mwelling/kimchi-display-lid/3D/QFN_6DSLTR_STM.step

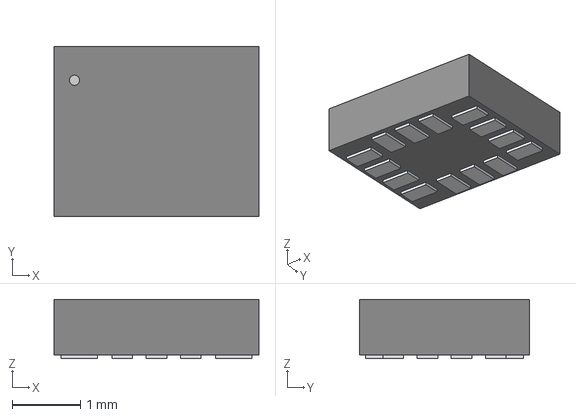
[picture p1: CAD file, 2021-01-25]
3D/QFN_6DSLTR_STM.step
3.00 x 2.49 x 0.866 mm
