mwelling/kimchi-display-lid/subassy/hoverboard/hoverboard.step

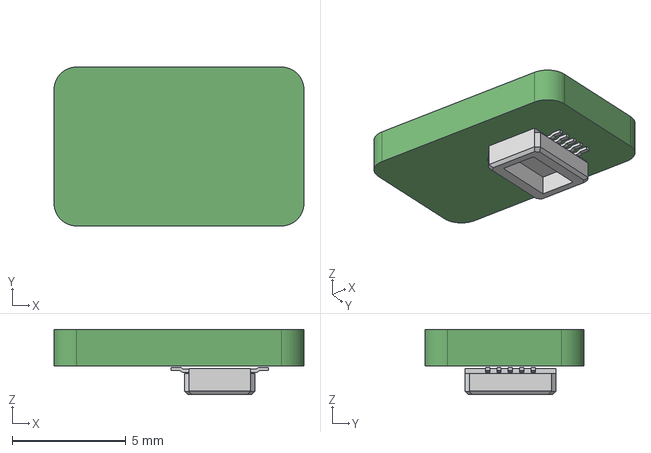
[picture p2: CAD file, 2021-01-31]
subassy/hoverboard/hoverboard.step
11.0 x 7.00 x 2.87 mm
