mwelling/kimchi-display-lid/3D/LCFE1210_LTF.step

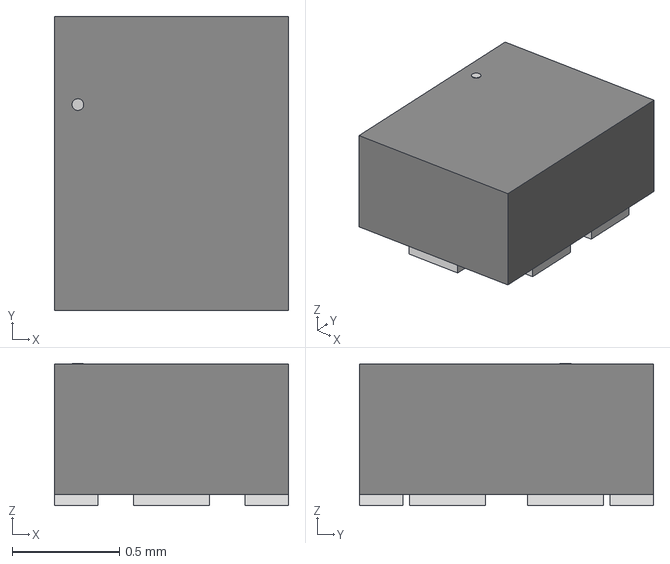
[picture p3: CAD file, 2020-12-23]
3D/LCFE1210_LTF.step
1.09 x 1.37 x 0.663 mm
