mwelling/kimchi-display-lid/3D/LGA-24L_3.5x3_0.43p.step

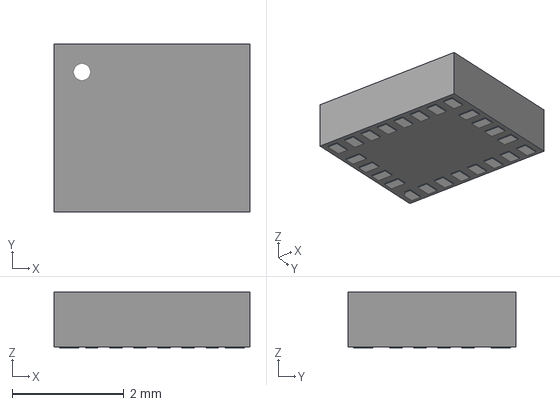
[picture p4: CAD file, 2020-12-20]
3D/LGA-24L_3.5x3_0.43p.step
3.50 x 3.00 x 1.00 mm
