mwelling/kimchi-display-lid/3D/1-292303-6.stp

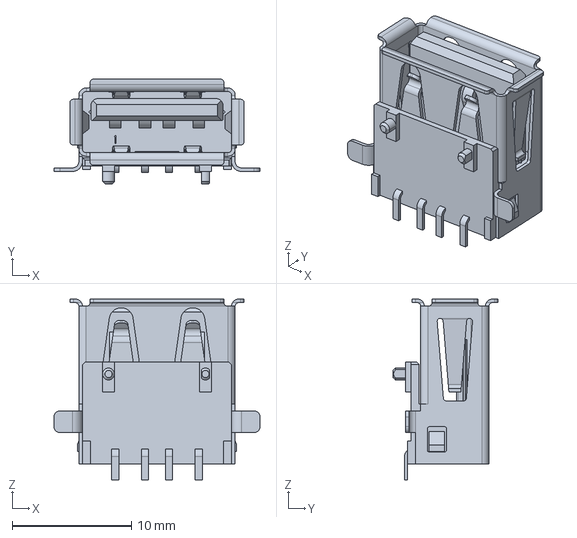
[picture p5: CAD file, 2020-12-20]
3D/1-292303-6.stp
17.3 x 8.79 x 15.2 mm
