mwelling/kimchi-display-lid/kimchi_display_lid.kicad_pcb

## KiCad design kimchi_display_lid.kicad_pcb (2021-02-05)

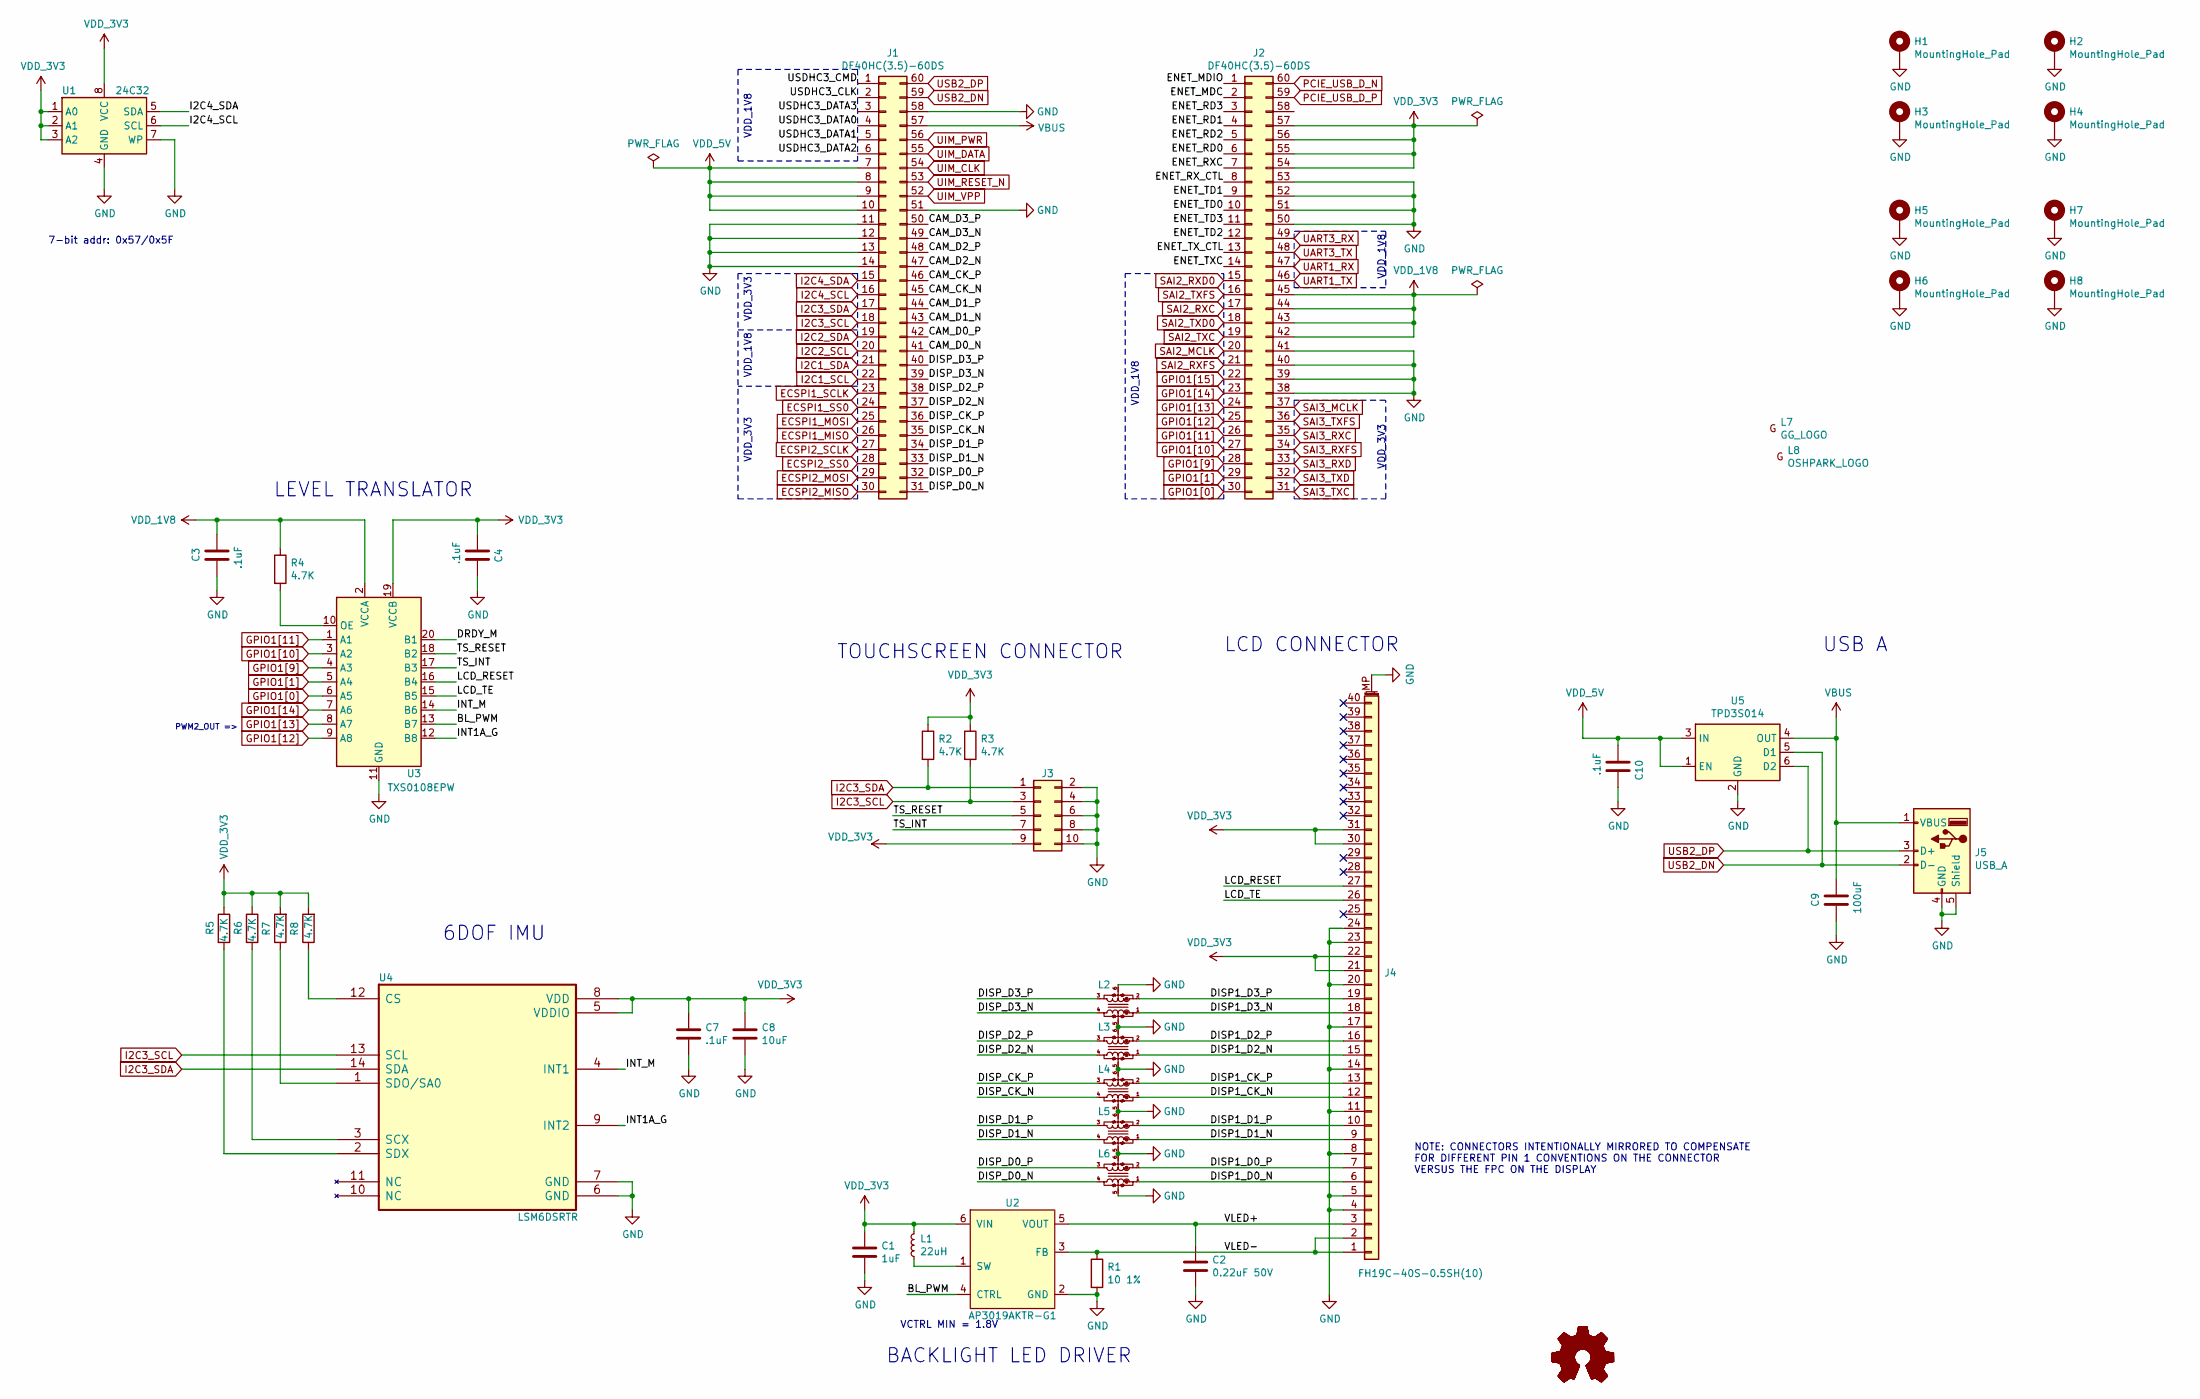
[picture p6: schematic kimchi_display_lid.sch]

Parts:
C1: 1uF; C_0603_1608Metric; Part C0603C105K4PAC7411
C2: 0.22uF 50V; C_0603_1608Metric; Part CGA3E3X7R1H224K080AB
C3, C4, C7, C10: .1uF; C_0603_1608Metric; Part C0603C104M5RACAUTO
C8: 10uF; C_0603_1608Metric; Part CL10A106MP8NNNC
C9: 100uF; C_1206_3216Metric; Part CC1206MKX5R5BB107
H1, H2, H3, H4, H5, H6, H7, H8: MountingHole_Pad; MountingHole_3mm_Pad
J1, J2: DF40HC(3.5)-60DS; Part DF40HC(3.5)-60DS
J3: Conn_02x05_Odd_Even; HIROSE_DF23C-10DS-0.5V(51)
J4: FH19C-40S-0.5SH(10); HRS_FH19C-40S-0.5SH_1x40-1MP_P0.50mm; Part FH19C-40S-0.5SH(10)
J5: USB_A; TE_1-292303-6; Part 1-292303-6
L1: 22uH; L_Taiyo-Yuden_MD-4040; Part TYA4012220M-10
L2, L3, L4, L5, L6: LCFE121002; Part LCFE121002
L7: GG_LOGO; groupgets_logo
L8: OSHPARK_LOGO; oshpark_logo
LOGO1: Logo_Open_Hardware_Small; OSHW-Logo_5.7x6mm_SilkScreen
LOGO2: Logo_Open_Hardware_Small; kimchi-micro-3d-model
LOGO3: Logo_Open_Hardware_Small; hoverboard-3d-model
R1: 10 1%; R_0603_1608Metric; Part RE0603FRE0710RL
R2, R3, R4, R5, R6, R7, R8: 4.7K; R_0603_1608Metric; Part RC0603JR-074K7L
U1: 24C32; DFN-8-1EP_3x2mm_P0.5mm_EP1.36x1.46mm; Part M24C32-FMC6TG
U2: AP3019AKTR-G1; SOT-23-6; Part AP3019AKTR-G1
U3: TXS0108EPW; TSSOP-20_4.4x6.5mm_P0.65mm; Part TXS0108EPW
U4: LSM6DSRTR
U5: TPD3S014; SOT-23-6; Part TPD3S014

Connections:
/BL_PWM: U2.4 (CTRL), U3.13 (B7)
/CAM_CK_N: J1.45
/CAM_CK_P: J1.46
/CAM_D0_N: J1.41
/CAM_D0_P: J1.42
/CAM_D1_N: J1.43
/CAM_D1_P: J1.44
/CAM_D2_N: J1.47
/CAM_D2_P: J1.48
/CAM_D3_N: J1.49
/CAM_D3_P: J1.50
/DISP1_CK_N: J4.12, L4.1
/DISP1_CK_P: J4.13, L4.2
/DISP1_D0_N: J4.6, L6.1
/DISP1_D0_P: J4.7, L6.2
/DISP1_D1_N: J4.9, L5.1
/DISP1_D1_P: J4.10, L5.2
/DISP1_D2_N: J4.15, L3.1
/DISP1_D2_P: J4.16, L3.2
/DISP1_D3_N: J4.18, L2.1
/DISP1_D3_P: J4.19, L2.2
/DISP_CK_N: J1.35, L4.4
/DISP_CK_P: J1.36, L4.3
/DISP_D0_N: J1.31, L6.4
/DISP_D0_P: J1.32, L6.3
/DISP_D1_N: J1.33, L5.4
/DISP_D1_P: J1.34, L5.3
/DISP_D2_N: J1.37, L3.4
/DISP_D2_P: J1.38, L3.3
/DISP_D3_N: J1.39, L2.4
/DISP_D3_P: J1.40, L2.3
/DRDY_M: U3.20 (B1)
/ENET_MDC: J2.2
/ENET_MDIO: J2.1
/ENET_RD0: J2.6
/ENET_RD1: J2.4
/ENET_RD2: J2.5
/ENET_RD3: J2.3
/ENET_RXC: J2.7
/ENET_RX_CTL: J2.8
/ENET_TD0: J2.10
/ENET_TD1: J2.9
/ENET_TD2: J2.12
/ENET_TD3: J2.11
/ENET_TXC: J2.14
/ENET_TX_CTL: J2.13
/INT1A_G: U3.12 (B8), U4.9 (INT2)
/INT_M: U3.14 (B6), U4.4 (INT1)
/LCD_RESET: J4.27, U3.16 (B4)
/LCD_TE: J4.26, U3.15 (B5)
/TS_INT: J3.7, U3.17 (B3)
/TS_RESET: J3.5, U3.18 (B2)
/USDHC3_CLK: J1.2
/USDHC3_CMD: J1.1
/USDHC3_DATA0: J1.4
/USDHC3_DATA1: J1.5
/USDHC3_DATA2: J1.6
/USDHC3_DATA3: J1.3
/VLED+: C2.1, J4.3, U2.5 (VOUT)
/VLED-: J4.1, J4.2, R1.1, U2.3 (FB)
ECSPI1_MISO: J1.26
ECSPI1_MOSI: J1.25
ECSPI1_SCLK: J1.23
ECSPI1_SS0: J1.24
ECSPI2_MISO: J1.30
ECSPI2_MOSI: J1.29
ECSPI2_SCLK: J1.27
ECSPI2_SS0: J1.28
GND: C1.2, C2.2, C3.2, C4.1, C7.2, C8.2, C9.2, C10.1, H1.1, H2.1, H3.1, H4.1, H5.1, H6.1, H7.1, H8.1, J1.11, J1.12, J1.13, J1.14, J1.51, J1.58, J2.38, J2.39, J2.40, J2.41, J2.50, J2.51, J2.52, J2.53, J3.2, J3.4, J3.6, J3.8, J3.10, J4.4, J4.5, J4.8, J4.11, J4.14, J4.17, J4.20, J4.23, J4.24, J4.MP (MountPin), J5.4 (GND), J5.5 (Shield), L2.5, L2.6 (5), L3.5, L3.6 (5), L4.5, L4.6 (5), L5.5, L5.6 (5), L6.5, L6.6 (5), R1.2, U1.4 (GND), U1.7 (WP), U2.2 (GND), U3.11 (GND), U4.6 (GND), U4.7 (GND), U5.2 (GND)
GPIO1[0]: J2.30, U3.6 (A5)
GPIO1[1]: J2.29, U3.5 (A4)
GPIO1[9]: J2.28, U3.4 (A3)
GPIO1[10]: J2.27, U3.3 (A2)
GPIO1[11]: J2.26, U3.1 (A1)
GPIO1[12]: J2.25, U3.9 (A8)
GPIO1[13]: J2.24, U3.8 (A7)
GPIO1[14]: J2.23, U3.7 (A6)
GPIO1[15]: J2.22
I2C1_SCL: J1.22
I2C1_SDA: J1.21
I2C2_SCL: J1.20
I2C2_SDA: J1.19
I2C3_SCL: J1.18, J3.3, R3.2, U4.13 (SCL)
I2C3_SDA: J1.17, J3.1, R2.2, U4.14 (SDA)
I2C4_SCL: J1.16, U1.6 (SCL)
I2C4_SDA: J1.15, U1.5 (SDA)
unnamed: L1.1, U2.1 (SW)
unnamed: R4.2, U3.10 (OE)
unnamed: R5.2, U4.2 (SDX)
unnamed: R6.2, U4.3 (SCX)
unnamed: R7.1, U4.1 (SDO/SA0)
unnamed: R8.1, U4.12 (CS)
PCIE_USB_D_N: J2.60
PCIE_USB_D_P: J2.59
SAI2_MCLK: J2.20
SAI2_RXC: J2.17
SAI2_RXD0: J2.15
SAI2_RXFS: J2.21
SAI2_TXC: J2.19
SAI2_TXD0: J2.18
SAI2_TXFS: J2.16
SAI3_MCLK: J2.37
SAI3_RXC: J2.35
SAI3_RXD: J2.33
SAI3_RXFS: J2.34
SAI3_TXC: J2.31
SAI3_TXD: J2.32
SAI3_TXFS: J2.36
UART1_RX: J2.47
UART1_TX: J2.46
UART3_RX: J2.49
UART3_TX: J2.48
UIM_CLK: J1.54
UIM_DATA: J1.55
UIM_PWR: J1.56
UIM_RESET_N: J1.53
UIM_VPP: J1.52
USB2_DN: J1.59, J5.2 (D-), U5.5 (D1)
USB2_DP: J1.60, J5.3 (D+), U5.6 (D2)
VBUS: C9.1, J1.57, J5.1 (VBUS), U5.4 (OUT)
VDD_1V8: C3.1, J2.42, J2.43, J2.44, J2.45, R4.1, U3.2 (VCCA)
VDD_3V3: C1.1, C4.2, C7.1, C8.1, J2.54, J2.55, J2.56, J2.57, J3.9, J4.21, J4.22, J4.30, J4.31, L1.2, R2.1, R3.1, R5.1, R6.1, R7.2, R8.2, U1.1 (A0), U1.2 (A1), U1.3 (A2), U1.8 (VCC), U2.6 (VIN), U3.19 (VCCB), U4.5 (VDDIO), U4.8 (VDD)
VDD_5V: C10.2, J1.7, J1.8, J1.9, J1.10, U5.1 (EN), U5.3 (IN)

Notes on the sheet:
7-bit addr: 0x57/0x5F
VDD_1V8
VDD_3V3
BACKLIGHT LED DRIVER
VCTRL MIN = 1.8V
TOUCHSCREEN CONNECTOR
LCD CONNECTOR
NOTE: CONNECTORS INTENTIONALLY MIRRORED TO COMPENSATE FOR DIFFERENT PIN 1 CONVENTIONS ON THE CONNECTOR VERSUS THE FPC ON THE DISPLAY
LEVEL TRANSLATOR
PWM2_OUT =>
USB A
6DOF IMU

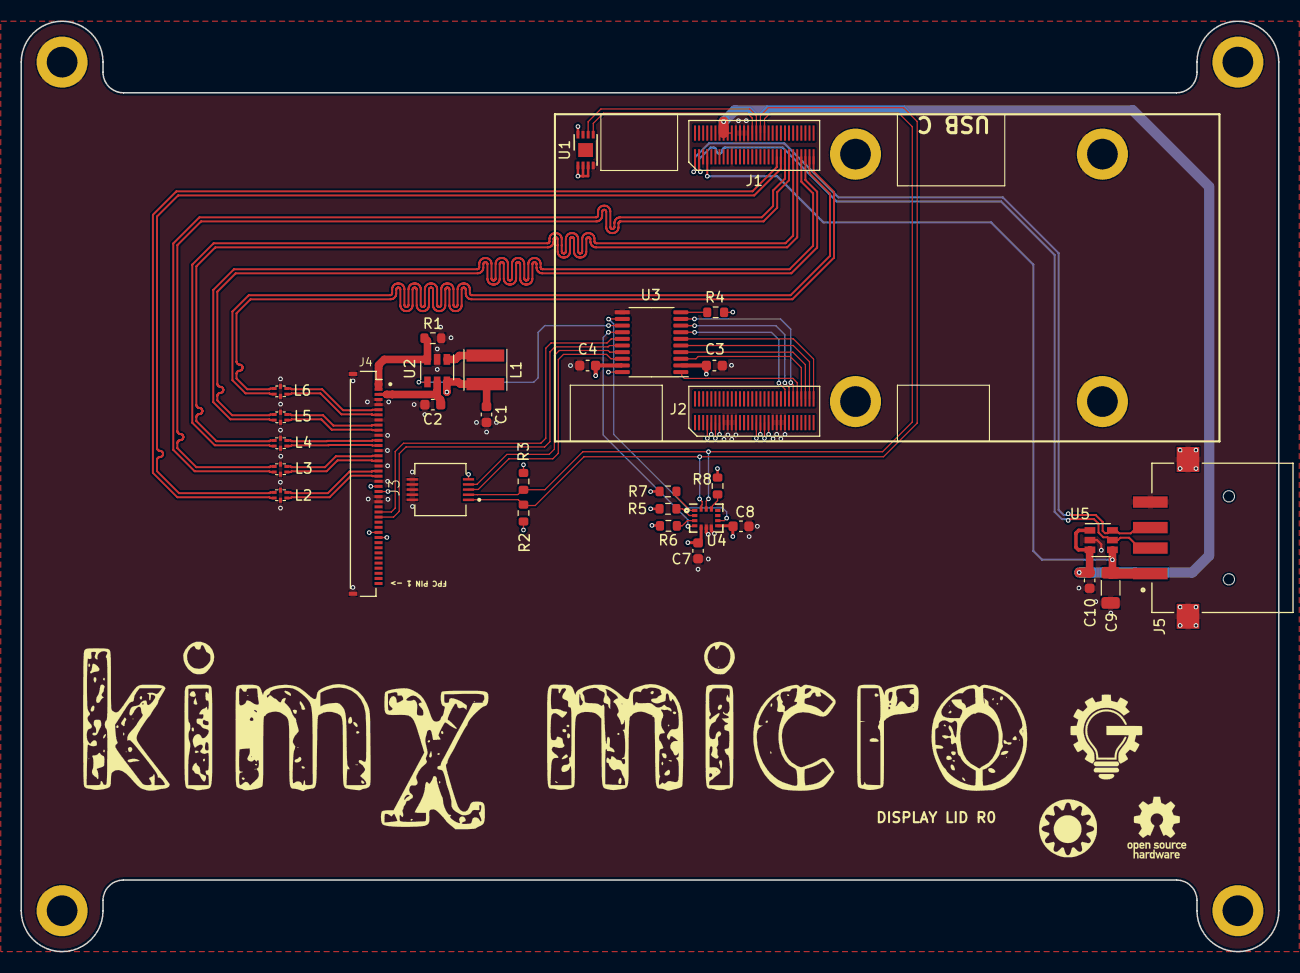
[picture p7: board kimchi_display_lid.kicad_pcb from above]

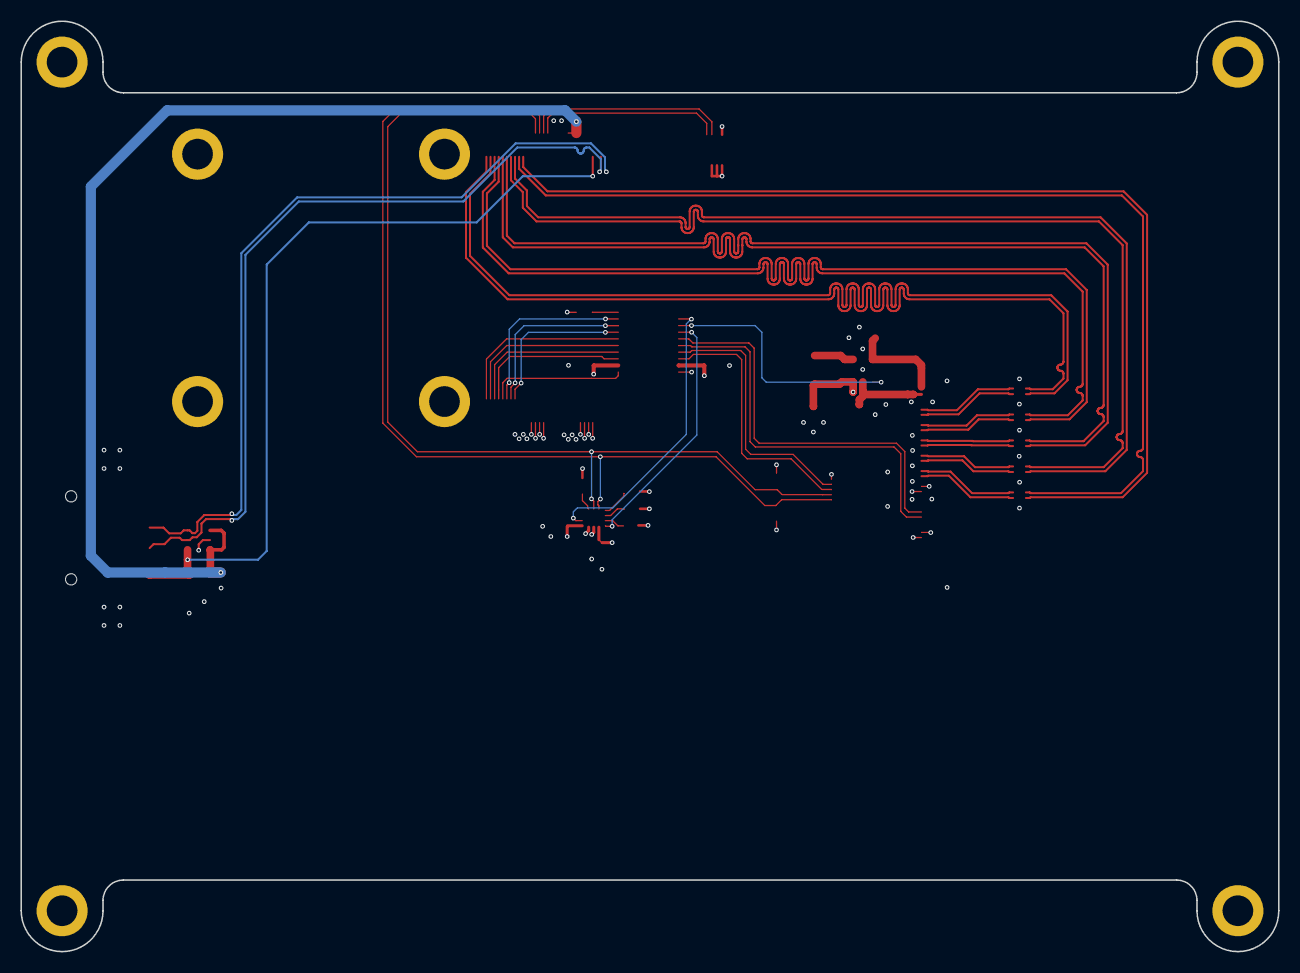
[picture p8: board kimchi_display_lid.kicad_pcb from below]

Board: 4 copper layers, 123.0 x 91.0 mm, 45 parts (8 on the bottom side), 54 nets.
