mwelling/kimchi-display-lid/kimchi_ulid.kicad_pcb

## KiCad design kimchi_ulid.kicad_pcb (2020-12-14)

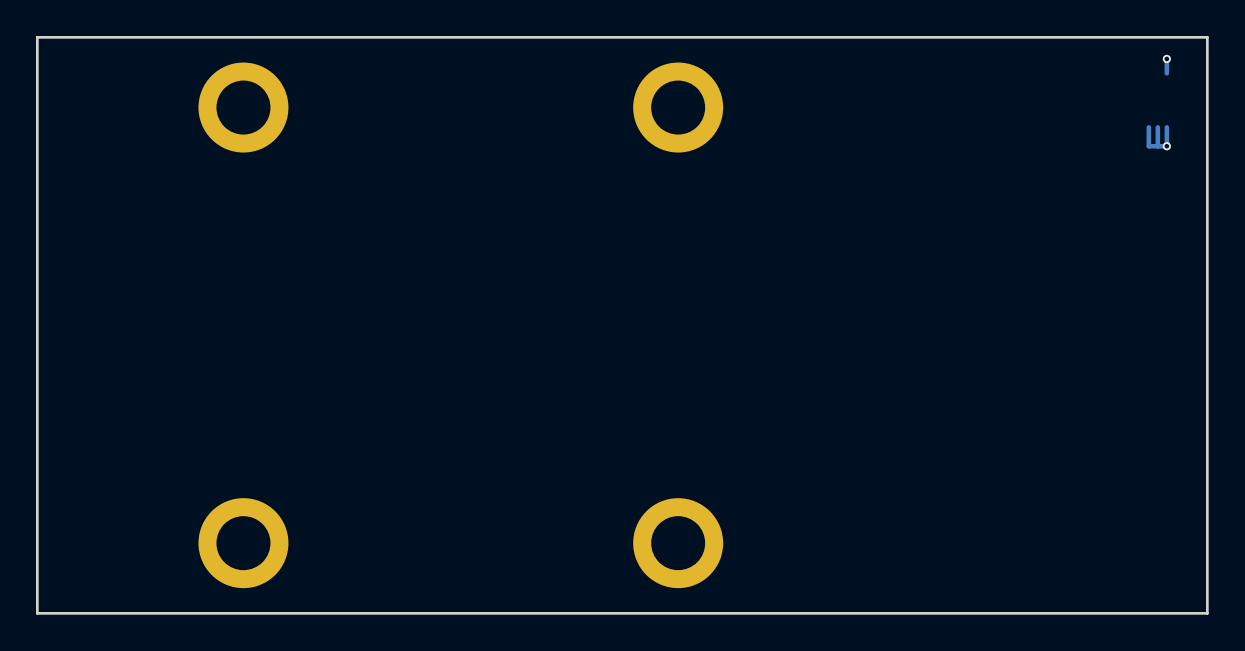
[picture p9: board kimchi_ulid.kicad_pcb from above]

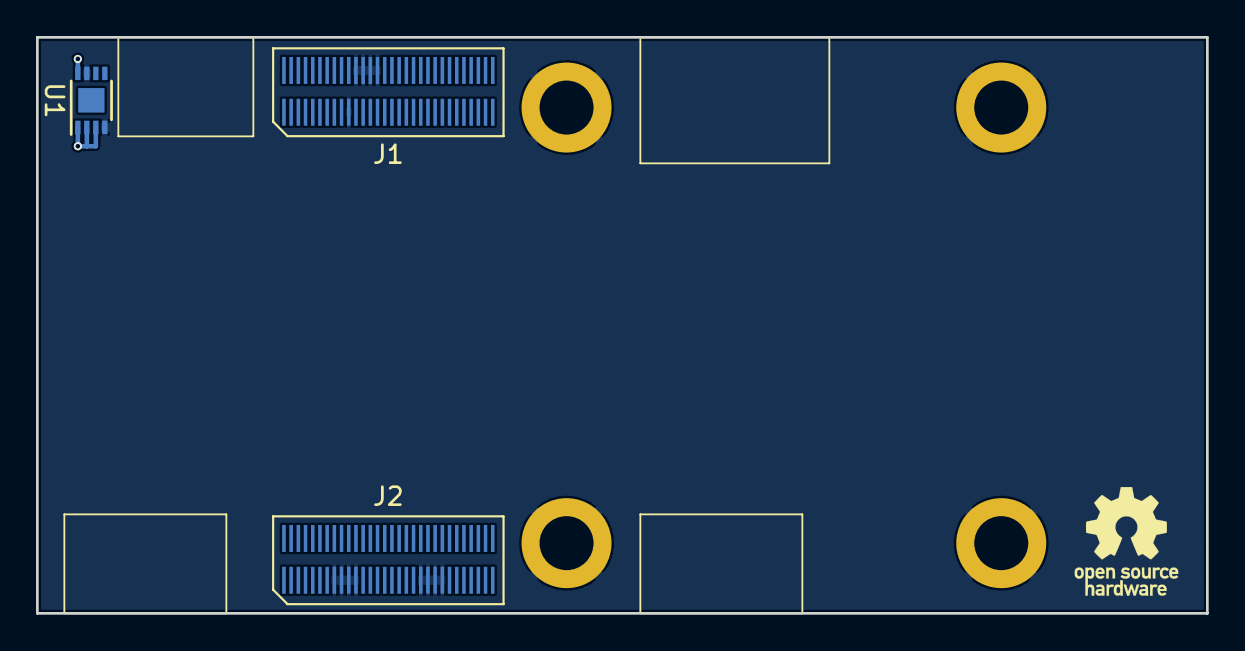
[picture p10: board kimchi_ulid.kicad_pcb from below]

Board: 4 copper layers, 65.0 x 32.0 mm, 8 parts (4 on the bottom side), 6 nets.

Parts:
H1, H2, H3, H4: MountingHole_Pad; MountingHole_3mm_Pad
J1, J2: DF40HC(3.5)-60DS
LOGO1: Logo_Open_Hardware_Small; OSHW-Logo_5.7x6mm_SilkScreen
U1: 24C32; DFN-8-1EP_3x2mm_P0.5mm_EP1.36x1.46mm

Connections:
GND: H1.1, H2.1, H3.1, H4.1, J1.11, J1.12, J1.13, J1.14, J1.51, J2.38, J2.39, J2.40, J2.41, J2.50, J2.51, J2.52, J2.53, U1.4, U1.7
I2C4_SCL: J1.16, U1.6
I2C4_SDA: J1.15, U1.5
VDD_1V8: J2.42, J2.43, J2.44, J2.45
VDD_3V3: J2.54, J2.55, J2.56, J2.57, U1.1, U1.2, U1.3, U1.8
VDD_5V: J1.7, J1.8, J1.9, J1.10
