mwelling/kimchi-display-lid/(commit log)

2020-12-14 Clean up
    [kimchi_display_lid.kicad_pcb, kimchi_display_lid.sch]
2020-12-14 Add board outline
    [kimchi_display_lid.kicad_pcb, kimchi_display_lid.sch]
2020-12-14 Add 3D model for the kimchi micro
    The PEMs are supposed to be 3.5mm but the spacing is enforced in the footprint.
    [kimchi_display_lid.kicad_pcb]
2020-12-14 Put 3D model in PCB
    For virtual fitment checks :)
    [kimchi_display_lid.kicad_pcb]
2020-12-14 Add LCD backlight LED driver
    [kimchi_display_lid.kicad_pcb, kimchi_display_lid.sch]
2020-12-14 Bump inductor to a big package
    [kimchi_display_lid.kicad_pcb, kimchi_display_lid.sch]
2020-12-14 Add some manufacturer part numbers
    So I don't forget them. ;)
    [kimchi_display_lid.sch]
2020-12-14 OCD fixes
    [kimchi_display_lid.sch]
2020-12-14 Add connectors for the LCD and touchscreen
    May need a level translator for the misc signals
2020-12-14 Add LCD connectors to the schematic / PCB
    [kimchi_display_lid.kicad_pcb, kimchi_display_lid.sch]
2020-12-15 Intentionally mirror the connections to FPC
    The pin 1 orientation of the FPC is opposite of the connector.
    [kimchi_display_lid.sch]
2020-12-15 Update placement of FPC connectors and kimx module
    Should be close enough.
    [kimchi_display_lid.kicad_pcb]
2020-12-20 Add level translator and route
    [kimchi_display_lid.kicad_pcb, kimchi_display_lid.sch]
2020-12-20 Add USB connector
    [1-292303-6.stp, kimchi_display_lid.kicad_pcb, kimchi_display_lid.sch]
2020-12-20 Move USB to opposite side of PCB
    It was in the way of the LCD cable on the other side. Doh!
    [kimchi_display_lid.kicad_pcb]
2020-12-20 Connect USB sheild to GND
    [kimchi_display_lid.kicad_pcb]
2020-12-20 Add 9DOF IMU
    [LGA-24L_3.5x3_0.43p.step, kimchi_display_lid.kicad_pcb, kimchi_display_lid.sch]
2020-12-20 Tweaky tweaks
    [kimchi_display_lid.kicad_pcb, kimchi_display_lid.sch]
2020-12-23 Add ESD protection and filtering to USB and DSI
    [LCFE1210_LTF.step, kimchi_display_lid.kicad_pcb, kimchi_display_lid.sch]
2020-12-25 Whooops PWM is on GPIO1_13
    [kimchi_display_lid.kicad_pcb, kimchi_display_lid.sch]
2021-01-13 Move the mounting holes to avoid blocking LCD FPC
    Also removes a bit length on the board to compensate for
    the cable wrapping around the PCB.
    May have to move the touchsreen connector and use an adapter
    to add length.
    [kimchi_display_lid.kicad_pcb, kimchi_display_lid.sch]
2021-01-13 Add part numbers to the schematic for BOM export
    [kimchi_display_lid.kicad_pcb, kimchi_display_lid.sch]
2021-01-21 IMU Changed
    9DOF IMU is out of stock, added new IMU that is 6DOF adjusted PCB design to include new IMU.
    [QFN_6DSLTR_STM.step, kimchi_display_lid.kicad_pcb, kimchi_display_lid.sch]
2021-01-25 Logos
    added logots
    [kimchi_display_lid.kicad_pcb, kimchi_display_lid.sch]
2021-01-31 Add a small board to connect touchscreen
    When the cables wrap around the PCB the distance between
    the 40pin and 6pin connectors is too close.
    The "hoverboard" floats over the 40pin connector to
    air jordan the 6pin down to the main board via a stacked
    connector pair.
    [hoverboard.kicad_pcb, hoverboard.sch, hoverboard.step, kimchi_display_lid.kicad_pcb, kimchi_display_lid.sch]
2021-02-03 Totally messed up the connections to the hoverboard
    Great scott!!
    Only caught this after placing an order at OSHpark.
    Swiftly cancelled for this fix.
    [hoverboard.kicad_pcb, hoverboard.sch, kimchi_display_lid.kicad_pcb]
2021-02-05 Add some silkscreen flare
    [kimchi_display_lid.kicad_pcb]
